wazzy2-hue/Node-Red-things/tda7294-mono/renders/board_bottom_flat.png

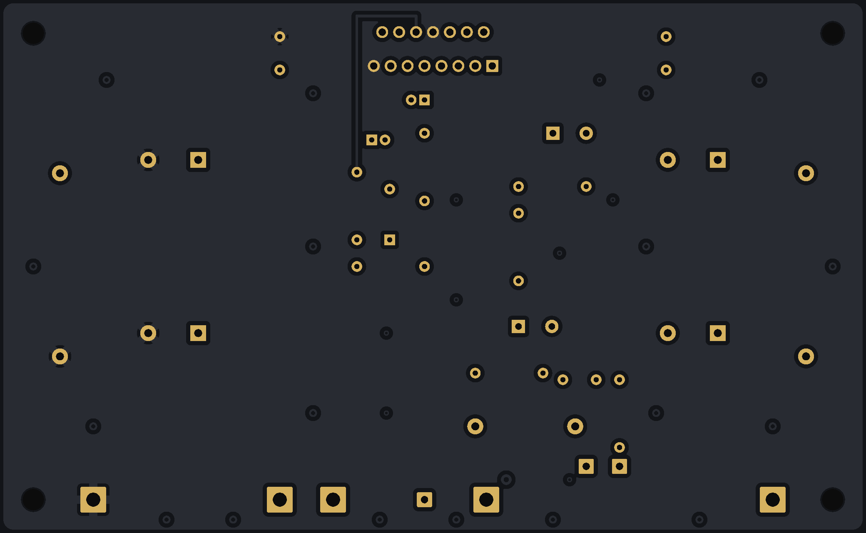
tda7294-mono/renders/board_bottom_flat.png
