wazzy2-hue/Node-Red-things/tda7294-mono/renders/board_top_flat.png

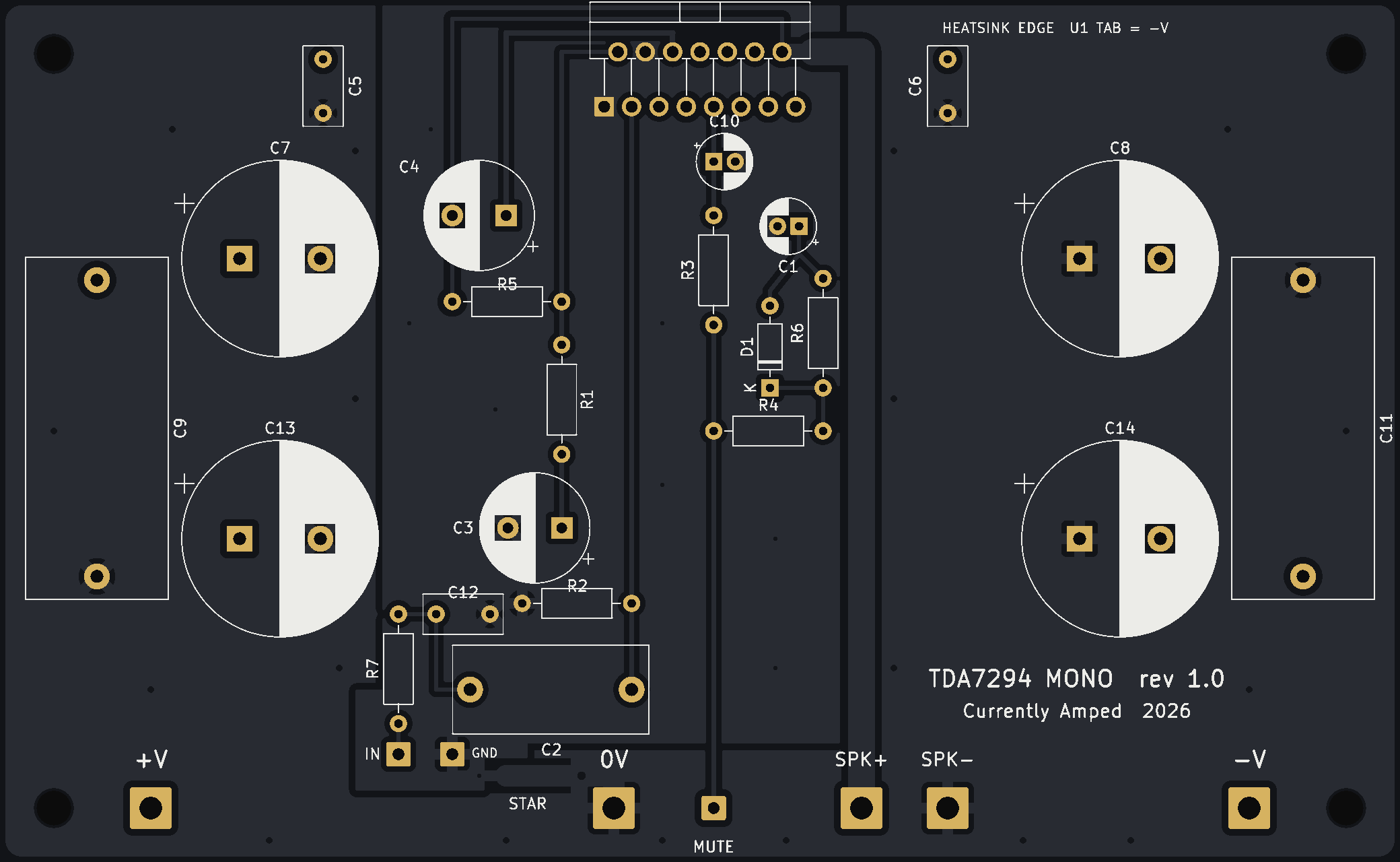
tda7294-mono/renders/board_top_flat.png
