wazzy2-hue/Node-Red-things/tda7294-mono/renders/render_3d_front.png

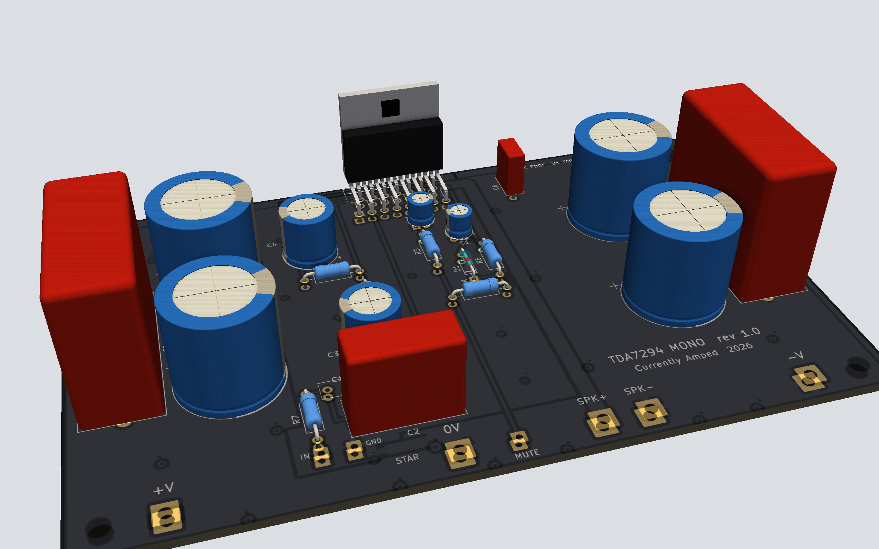
tda7294-mono/renders/render_3d_front.png
