wazzy2-hue/Node-Red-things/tda7294-mono/renders/render_3d_heatsink_side.png

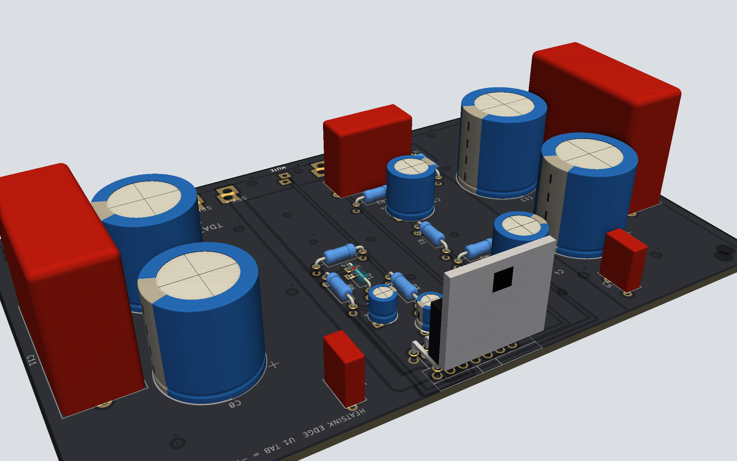
tda7294-mono/renders/render_3d_heatsink_side.png
