wazzy2-hue/Node-Red-things/tda7294-mono/renders/render_top.png

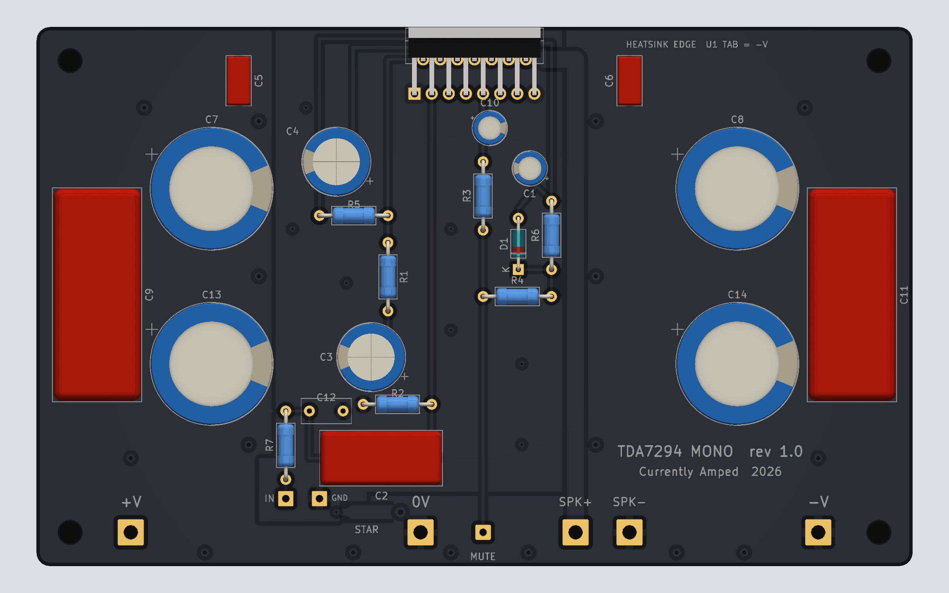
tda7294-mono/renders/render_top.png
