wazzy2-hue/Node-Red-things/tda7294-mono/fab/tda7294_mono_schematic.pdf

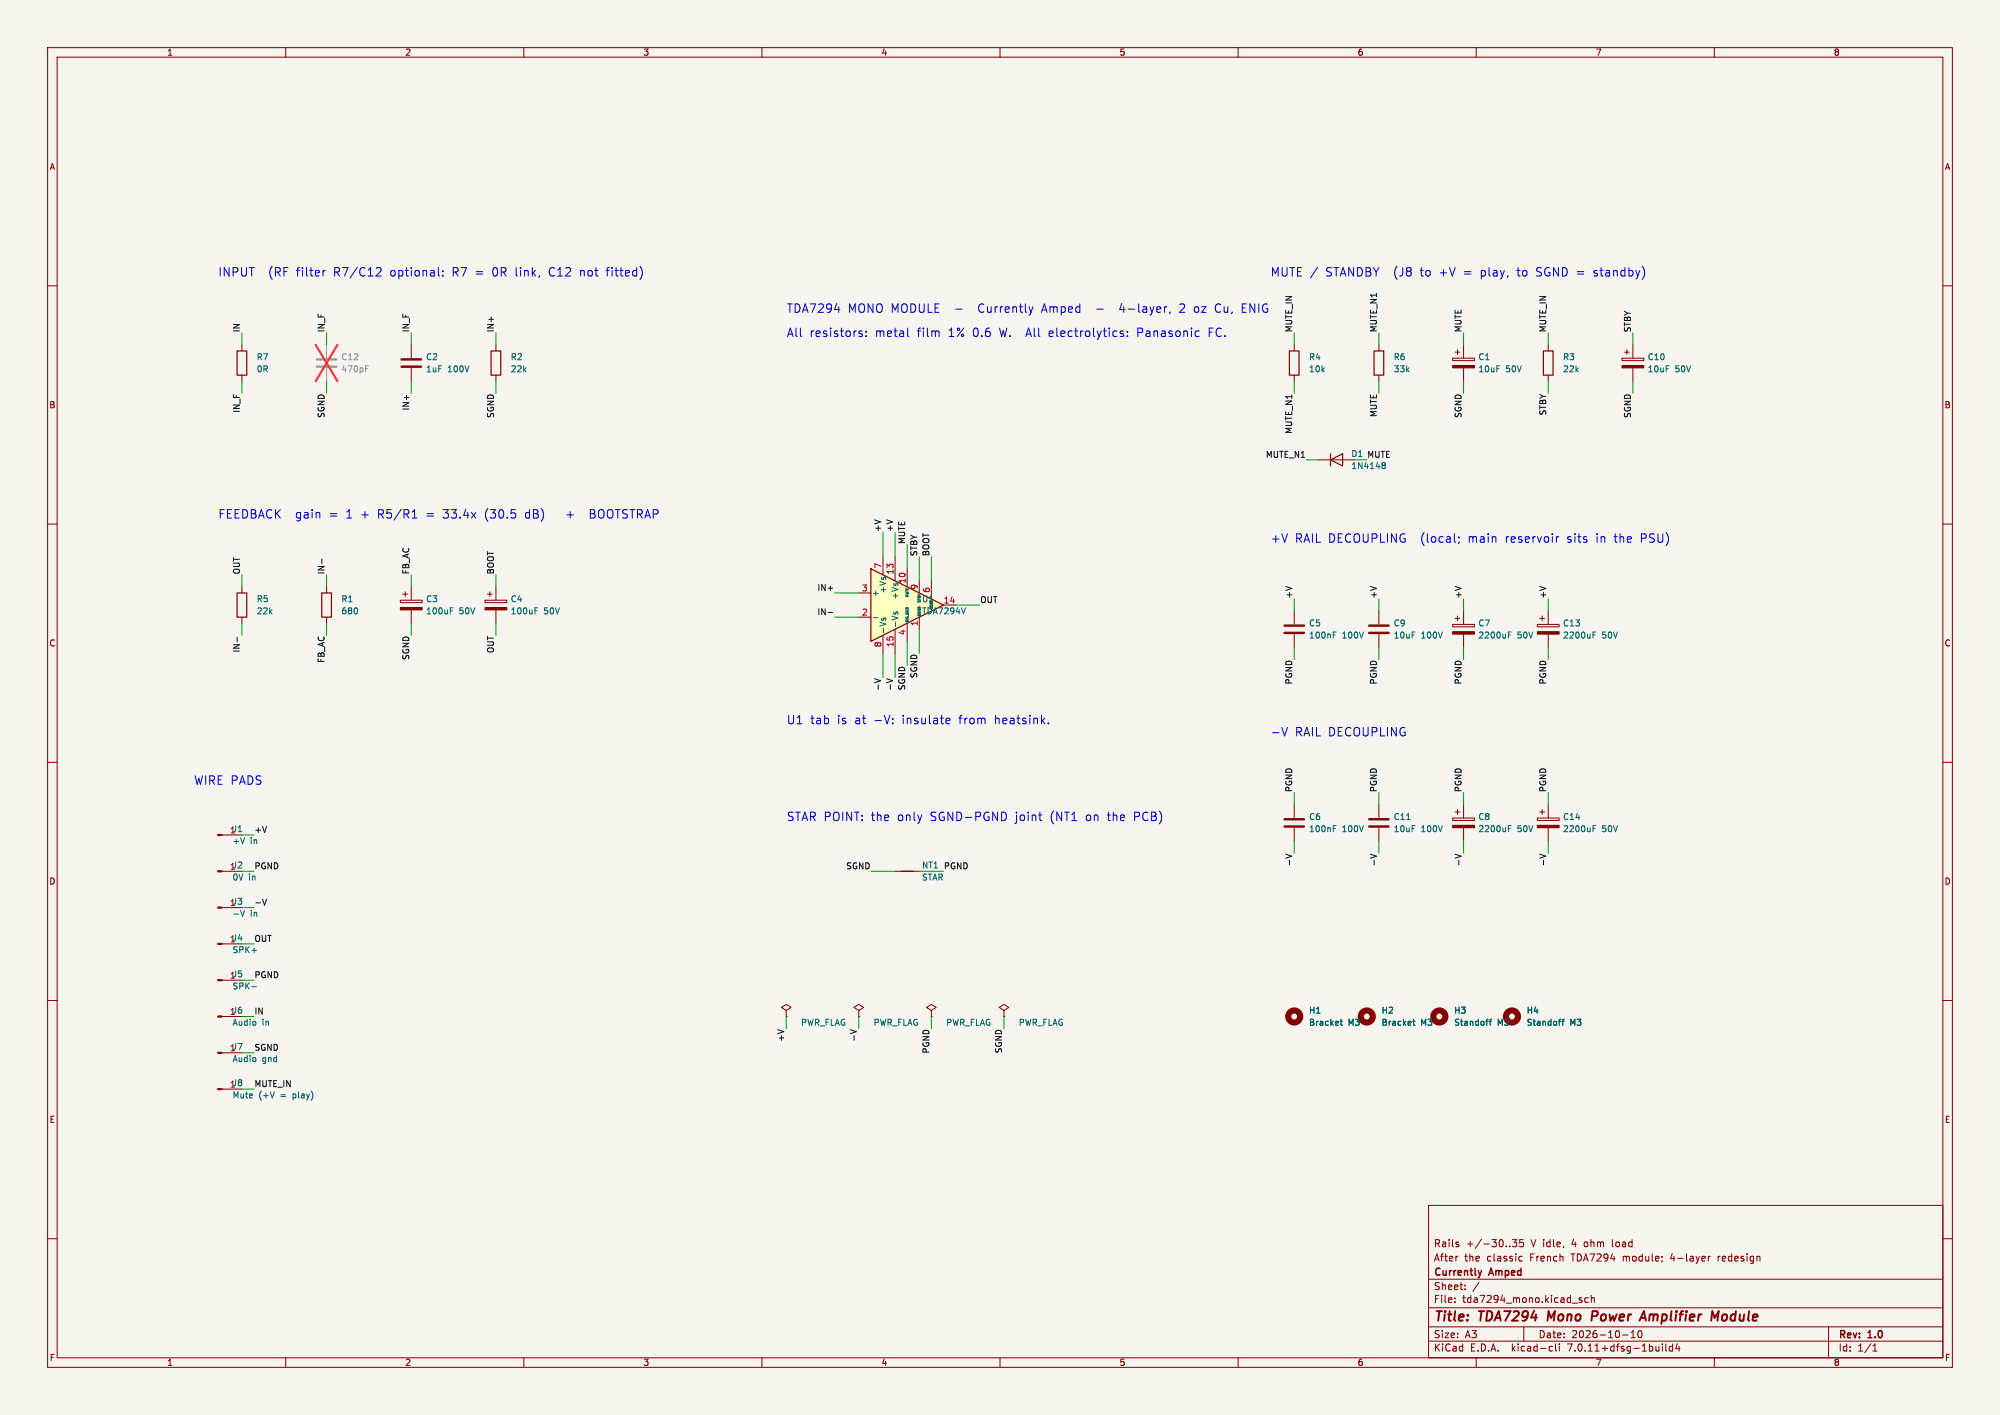
[picture p6: page 1]

MUTE / STANDBY (J8 to +V = play, to SGND = standby)

7 -Vs 8 STBY 9 U1 TDA7294V IN- +V BOOT PGND PGND PGND PGND -V-V STBY MUTE_N1 OUT SGND FB_AC +V+V

STAR POINT: the only SGND-PGND joint (NT1 on the PCB)

Id: 1/1 Title: TDA7294 Mono Power Amplifier Module
