wazzy2-hue/Node-Red-things/tda7294-mono/kicad/tda7294_mono.kicad_pcb

## KiCad design tda7294-mono/kicad/tda7294_mono.kicad_pcb (2026-10-11)

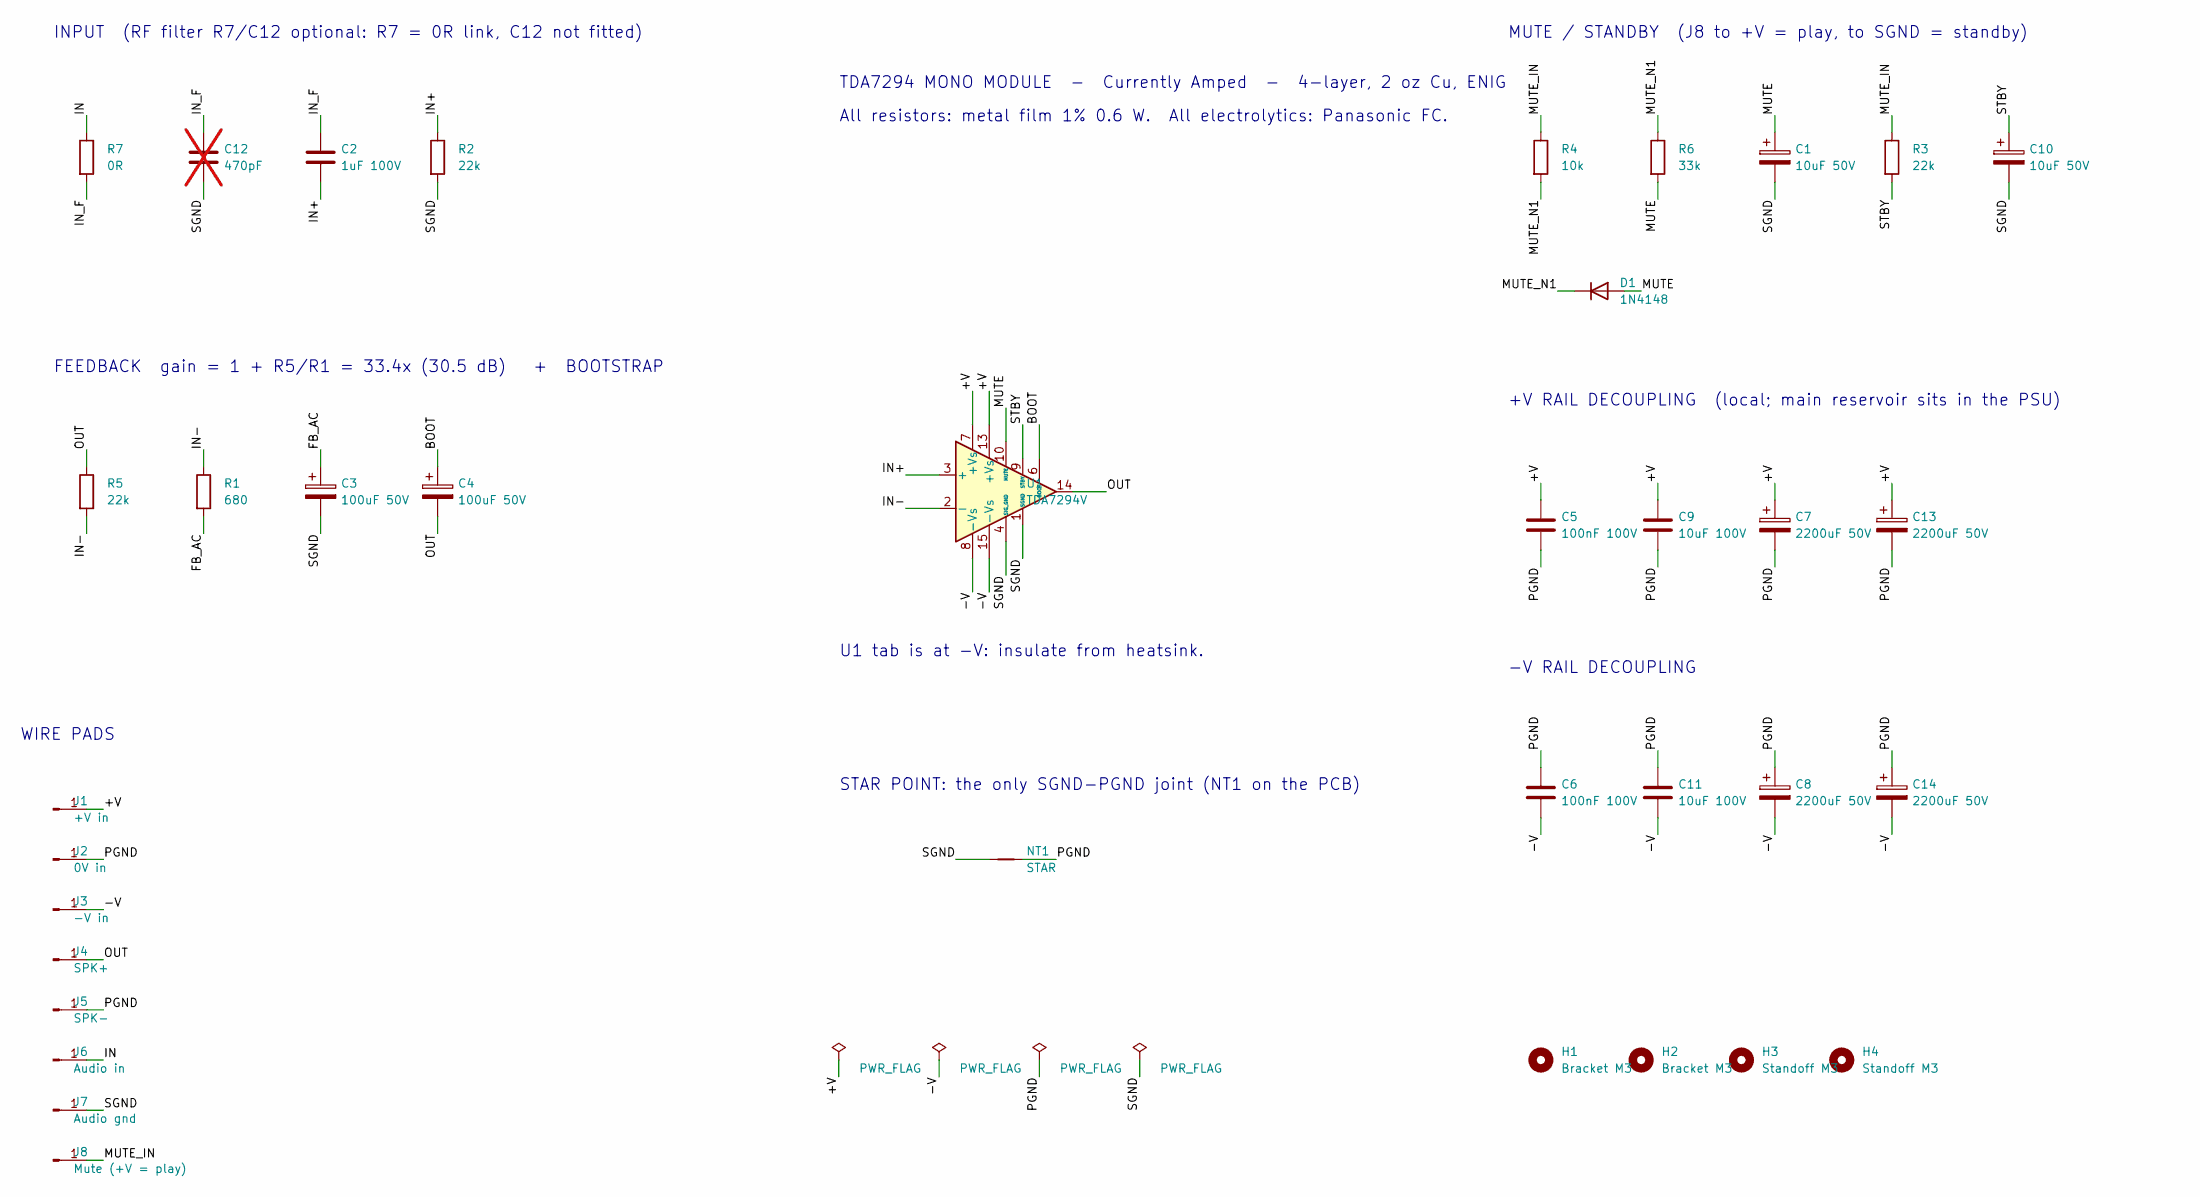
[picture p7: schematic tda7294_mono.kicad_sch, TDA7294 Mono Power Amplifier Module]

Parts:
C1, C10: 10uF 50V; CP_Radial_D5.0mm_P2.00mm; MPN EEU-FC1H100L
C2: 1uF 100V; C_Rect_L18.0mm_W8.0mm_P15.00mm_FKS3_FKP3
C3, C4: 100uF 50V; CP_Radial_D10.0mm_P5.00mm; MPN EEU-FC1H101
C5, C6: 100nF 100V; C_Rect_L7.2mm_W3.5mm_P5.00mm_FKS2_FKP2_MKS2_MKP2
C7, C8, C13, C14: 2200uF 50V; CP_Radial_D18.0mm_P7.50mm; MPN EEU-FC1H222
C9, C11: 10uF 100V; C_Rect_L31.5mm_W13.0mm_P27.50mm_MKS4
C12: 470pF; C_Rect_L7.2mm_W3.5mm_P5.00mm_FKS2_FKP2_MKS2_MKP2; not fitted
D1: 1N4148; D_DO-35_SOD27_P7.62mm_Horizontal
H1, H2: Bracket M3; MountingHole_3.2mm_M3
H3, H4: Standoff M3; MountingHole_3.2mm_M3
J1: +V in; SolderWire-1.5sqmm_1x01_D1.7mm_OD3.9mm
J2: 0V in; SolderWire-1.5sqmm_1x01_D1.7mm_OD3.9mm
J3: -V in; SolderWire-1.5sqmm_1x01_D1.7mm_OD3.9mm
J4: SPK+; SolderWire-1.5sqmm_1x01_D1.7mm_OD3.9mm
J5: SPK-; SolderWire-1.5sqmm_1x01_D1.7mm_OD3.9mm
J6: Audio in; SolderWire-0.5sqmm_1x01_D0.9mm_OD2.3mm
J7: Audio gnd; SolderWire-0.5sqmm_1x01_D0.9mm_OD2.3mm
J8: Mute (+V = play); SolderWire-0.5sqmm_1x01_D0.9mm_OD2.3mm
NT1: STAR; NetTie-2_SMD_Pad2.0mm
R1: 680; R_Axial_DIN0207_L6.3mm_D2.5mm_P10.16mm_Horizontal
R2, R3, R5: 22k; R_Axial_DIN0207_L6.3mm_D2.5mm_P10.16mm_Horizontal
R4: 10k; R_Axial_DIN0207_L6.3mm_D2.5mm_P10.16mm_Horizontal
R6: 33k; R_Axial_DIN0207_L6.3mm_D2.5mm_P10.16mm_Horizontal
R7: 0R; R_Axial_DIN0207_L6.3mm_D2.5mm_P10.16mm_Horizontal
U1: TDA7294V; TO-220-15_P2.54x2.54mm_StaggerOdd_Lead4.58mm_Vertical

Connections:
+V: C5.1, C7.1, C9.1, C13.1, J1.1, U1.7 (+Vs), U1.13 (+Vs)
-V: C6.2, C8.2, C11.2, C14.2, J3.1, U1.8 (-Vs), U1.15 (-Vs)
BOOT: C4.1, U1.6 (BOOT)
FB_AC: C3.1, R1.2
IN: J6.1, R7.1
IN+: C2.2, R2.1, U1.3 (+)
IN-: R1.1, R5.2, U1.2 (-)
IN_F: C2.1, C12.1, R7.2
MUTE: C1.1, D1.2 (A), R6.2, U1.10 (MUTE)
MUTE_IN: J8.1, R3.1, R4.1
MUTE_N1: D1.1 (K), R4.2, R6.1
OUT: C4.2, J4.1, R5.1, U1.14
PGND: C5.2, C6.1, C7.2, C8.1, C9.2, C11.1, C13.2, C14.1, J2.1, J5.1, NT1.2
SGND: C1.2, C3.2, C10.2, C12.2, J7.1, NT1.1, R2.2, U1.1 (SGND), U1.4 (SIG_GND)
STBY: C10.1, R3.2, U1.9 (STBY)

Notes on the sheet:
INPUT (RF filter R7/C12 optional: R7 = 0R link, C12 not fitted)
FEEDBACK gain = 1 + R5/R1 = 33.4x (30.5 dB) + BOOTSTRAP
MUTE / STANDBY (J8 to +V = play, to SGND = standby)
+V RAIL DECOUPLING (local; main reservoir sits in the PSU)
-V RAIL DECOUPLING
WIRE PADS
STAR POINT: the only SGND-PGND joint (NT1 on the PCB)
TDA7294 MONO MODULE - Currently Amped - 4-layer, 2 oz Cu, ENIG
All resistors: metal film 1% 0.6 W. All electrolytics: Panasonic FC.
U1 tab is at -V: insulate from heatsink.

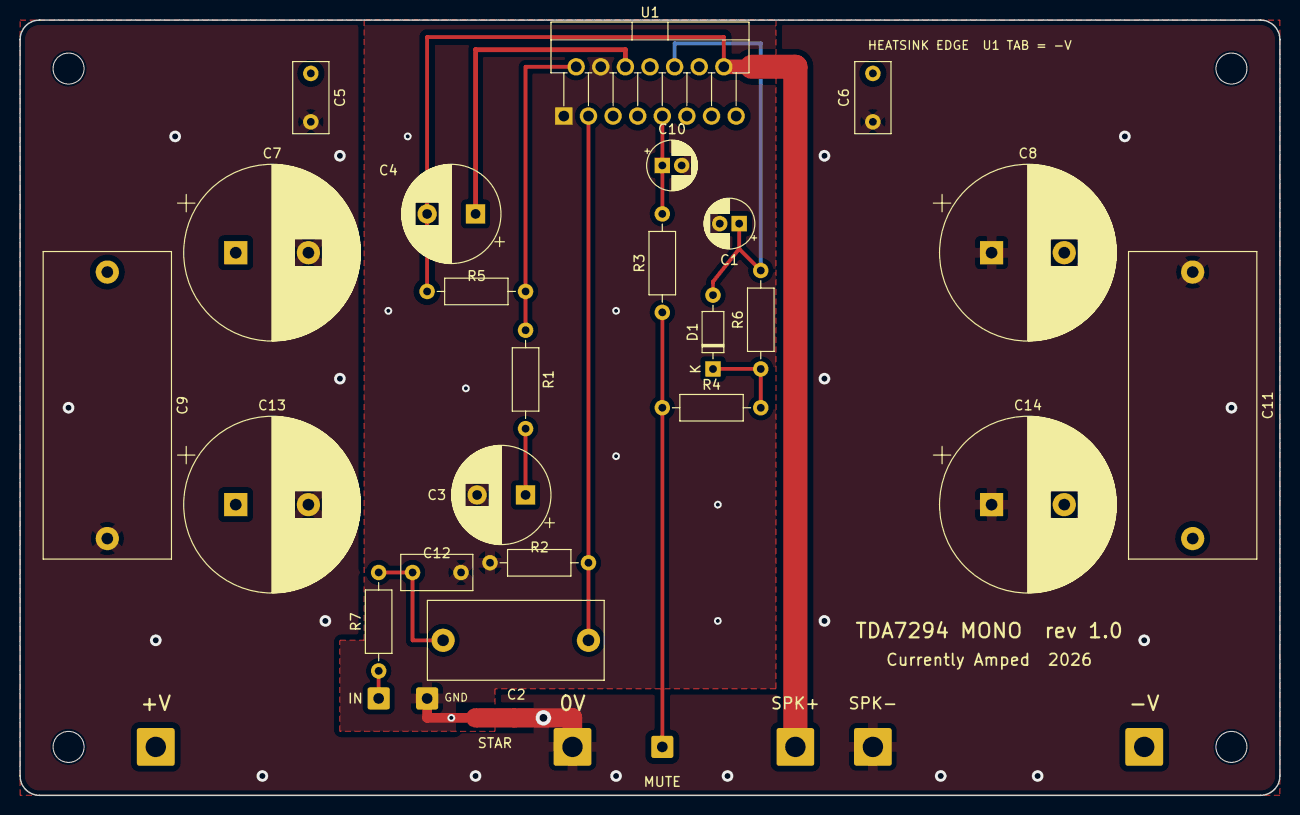
[picture p8: board tda7294_mono.kicad_pcb from above]

Board: 4 copper layers, 130.0 x 80.0 mm, 36 parts (0 on the bottom side), 15 nets.
