wazzy2-hue/Node-Red-things/(commit log)

2026-10-09 Add ETS config switch: show grid meter power instead of per-unit AC input
    Claude-Session: https://claude.ai/code/session_0151KHiL1zUGGurjkMxpFVgp
2026-10-11 Add TDA7294 mono amplifier reference design
    Import the 4-layer "definitive" TDA7294 mono power-amp module as a
    self-contained reference design under tda7294-mono/.
    Programmatically generated KiCad 7 project where gen/circuit.py is the
    single source of truth (parts, values, footprints, pin-to-net map);
    gen_sch.py / gen_pcb.py build the schematic and board from it, with
    check_net.py and drc.py for verification.
    Includes:
    - kicad/ KiCad project (.kicad_pro/.sch/.pcb) + custom TDA7294
    Multiwatt15 3D model
    - gen/ Python generators (source of truth + build/verify scripts)
    - fab/ Gerbers (4 copper layers), PTH/NPTH drills + maps, BOM,
    schematic PDF
    - renders/ 3D and fla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
    [tda7294_mono-B_Mask.gbs, tda7294_mono-B_NegRail.gbl, tda7294_mono-B_Silkscreen.gbo, tda7294_mono-Edge_Cuts.gm1, tda7294_mono-F_Cu.gtl, tda7294_mono-F_Mask.gts, tda7294_mono-F_Silkscreen.gto, tda7294_mono-NPTH.drl]
